inopya/Temporizador_salida_220v/images/screen1.jpg

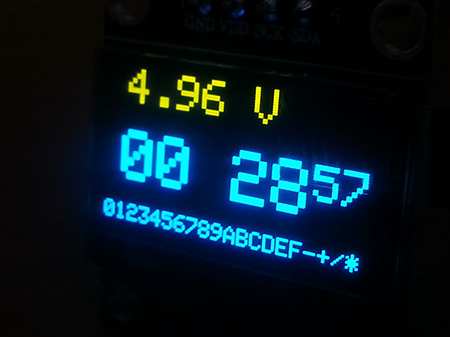
images/screen1.jpg
