inopya/Temporizador_salida_220v/images/theend.jpg

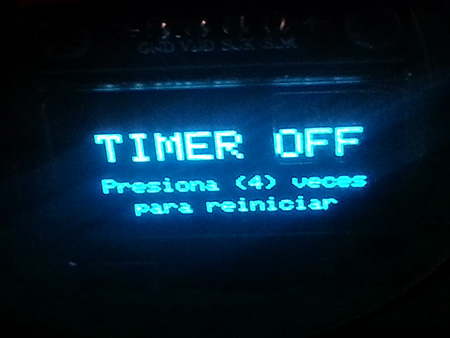
images/theend.jpg
