inopya/Temporizador_salida_220v/images/timer_off.jpg

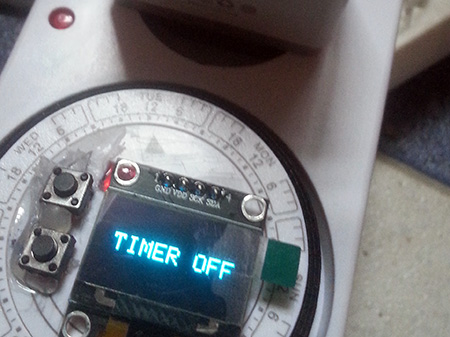
images/timer_off.jpg
